cy2016-1/bipedal_wheeled_robot/模型/外固定2.stl

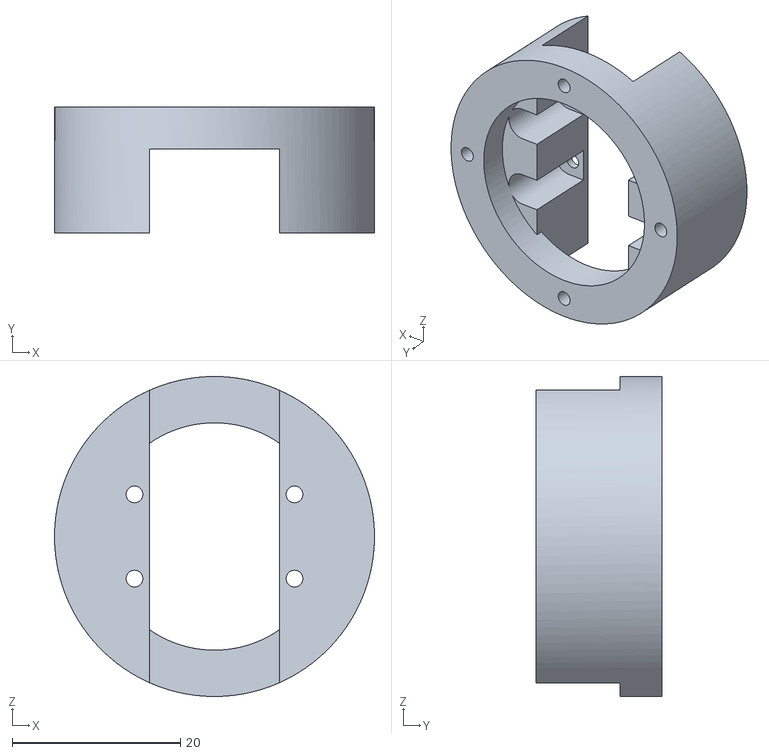
[picture p1: CAD file, 2024-07-26]
模型/外固定2.stl
38.0 x 15.0 x 38.0
