cy2016-1/bipedal_wheeled_robot/模型/舵机接口2.stl

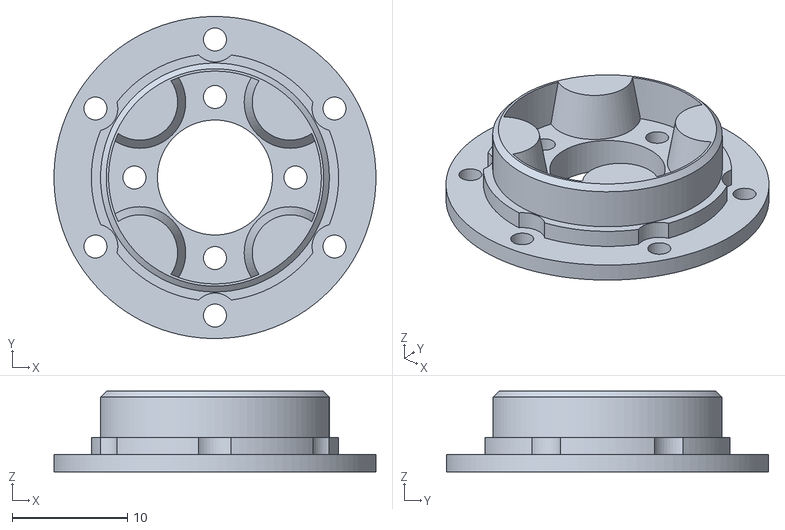
[picture p2: CAD file, 2024-07-26]
模型/舵机接口2.stl
28.0 x 28.0 x 7.00
