cy2016-1/bipedal_wheeled_robot/模型/盖板1.stl

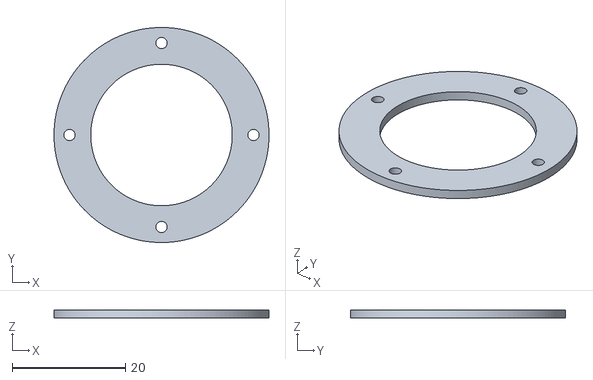
[picture p3: CAD file, 2024-07-26]
模型/盖板1.stl
38.0 x 38.0 x 1.50
