cy2016-1/bipedal_wheeled_robot/模型/上盖.stl

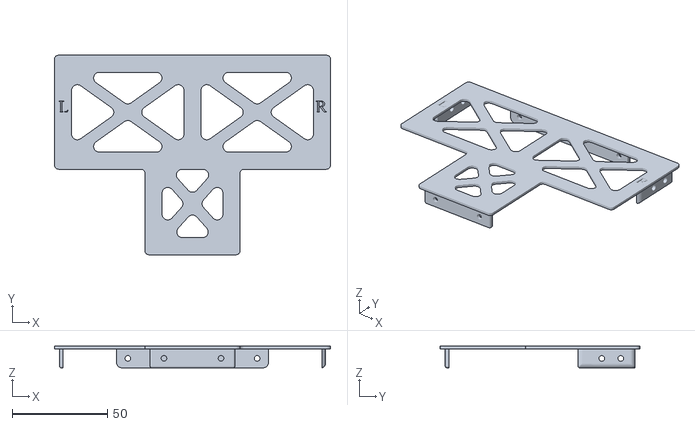
[picture p4: CAD file, 2024-06-26]
模型/上盖.stl
145.2 x 105.0 x 11.5
