cy2016-1/bipedal_wheeled_robot/模型/前小臂X1.stl

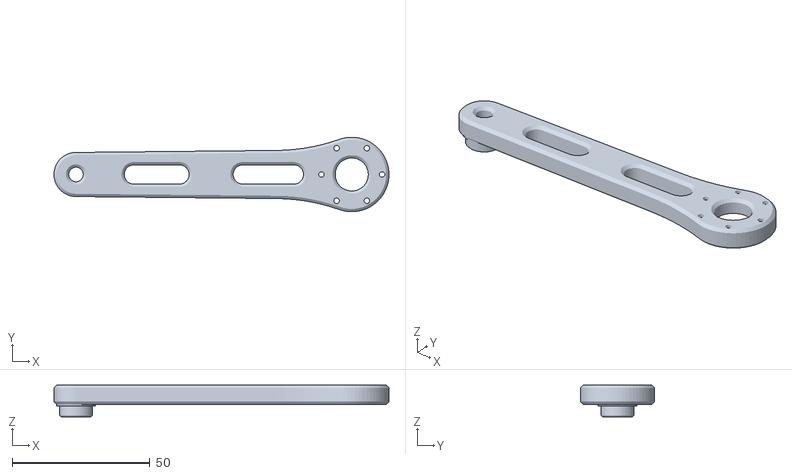
[picture p5: CAD file, 2024-06-26]
模型/前小臂X1.stl
121.5 x 27.0 x 11.5
