cy2016-1/bipedal_wheeled_robot/模型/轮固定X1.stl

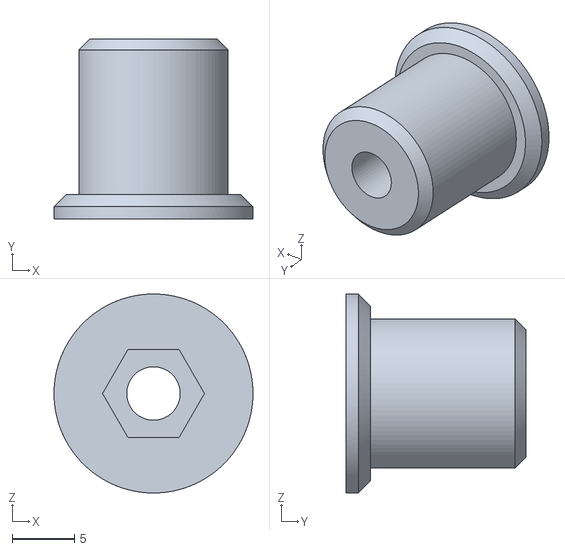
[picture p6: CAD file, 2024-06-26]
模型/轮固定X1.stl
16.0 x 14.5 x 16.0
