cy2016-1/bipedal_wheeled_robot/模型/轮毂X1.stl

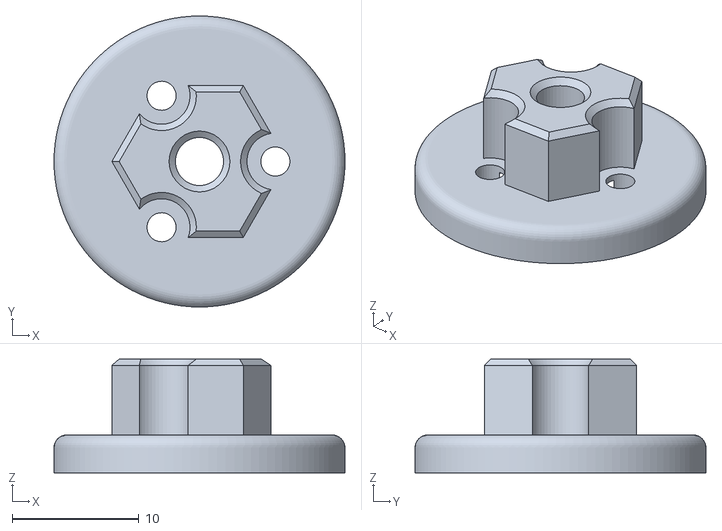
[picture p7: CAD file, 2024-06-26]
模型/轮毂X1.stl
23.0 x 23.0 x 9.00
