cy2016-1/bipedal_wheeled_robot/模型/框架.stl

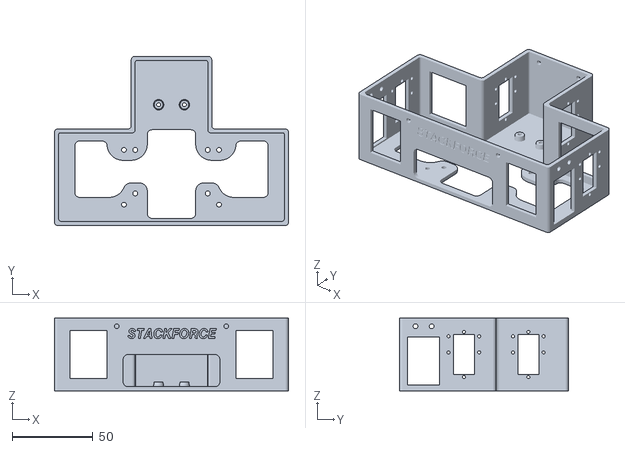
[picture p8: CAD file, 2024-06-26]
模型/框架.stl
145.2 x 105.0 x 45.0
