cy2016-1/bipedal_wheeled_robot/模型/后小臂X1.stl

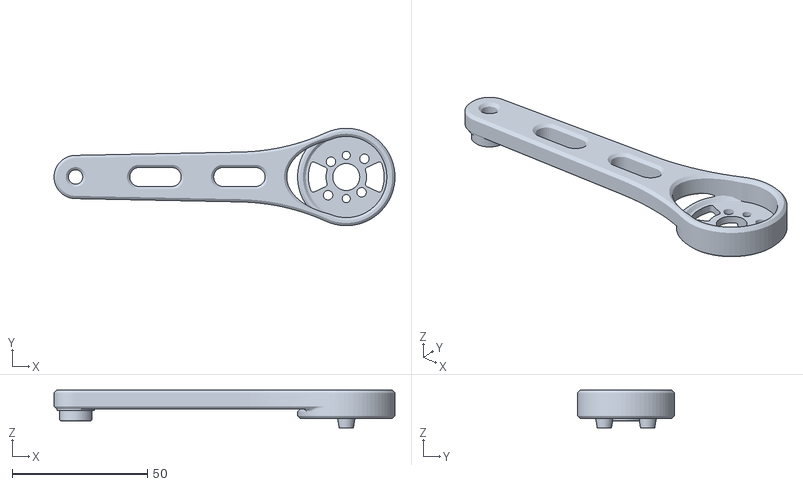
[picture p9: CAD file, 2024-06-26]
模型/后小臂X1.stl
126.0 x 36.0 x 14.0
