cy2016-1/bipedal_wheeled_robot/模型/大腿4.stl

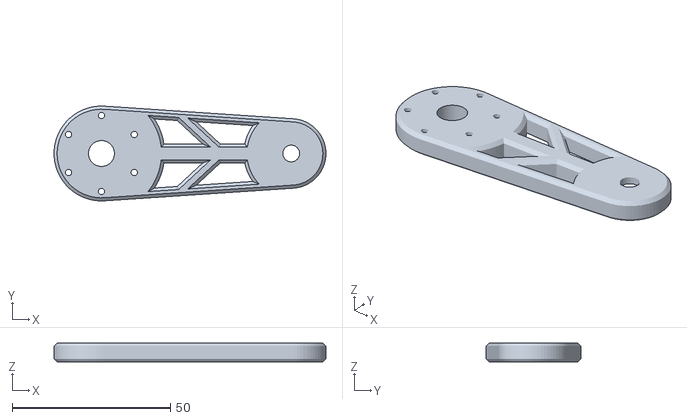
[picture p10: CAD file, 2024-06-26]
模型/大腿4.stl
86.0 x 30.0 x 6.00
