cy2016-1/bipedal_wheeled_robot/模型/电池架.stl

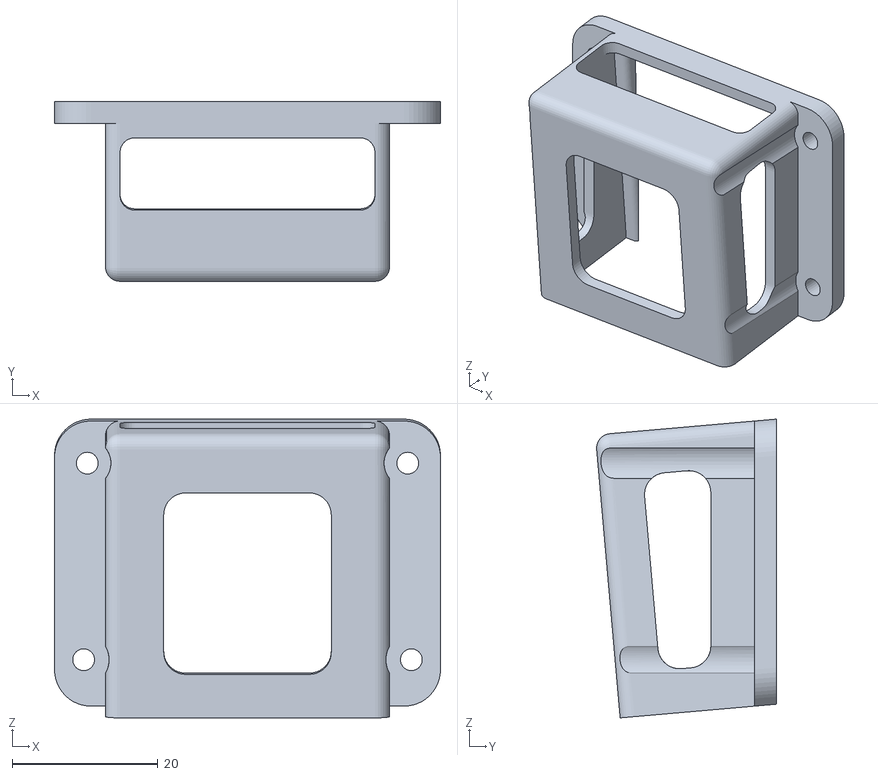
[picture p11: CAD file, 2024-06-26]
模型/电池架.stl
53.0 x 24.7 x 41.0
