cy2016-1/bipedal_wheeled_robot/模型/电机固定X1.stl

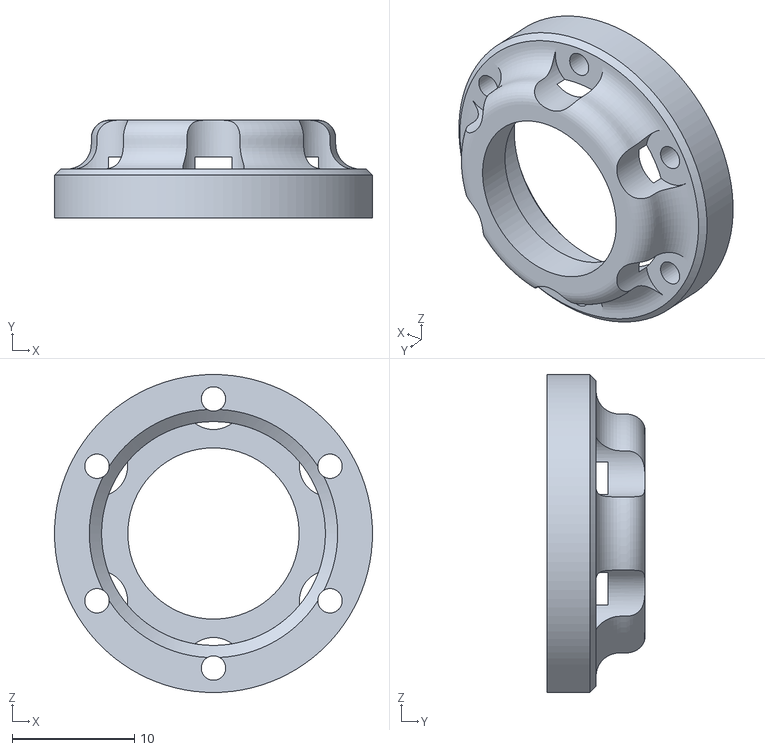
[picture p12: CAD file, 2024-06-26]
模型/电机固定X1.stl
26.0 x 8.00 x 26.0
