cy2016-1/bipedal_wheeled_robot/课程代码/第六课_运动学逆解/lesson6_HeightCtrl/src/main.cpp

#include <Arduino.h>
#include "SF_Servo.h"
#include "sbus.h"
#include "bipedal_data.h"

#define ROLL_OFFSET 0

SF_Servo servos = SF_Servo(Wire); //实例化舵机
bfs::SbusRx sbusRx(&Serial1);//实例化接收机

#define _constrain(amt, low, high) ((amt) < (low) ? (low) : ((amt) > (high) ? (high) : (amt))) // 限幅函数

void getRCValue();
void setServoAngle(uint16_t servoLeftFront, uint16_t servoLeftRear, uint16_t servoRightFront, uint16_t servoRightRear);
void inverseKinematics();

std::array<int16_t, bfs::SbusRx::NUM_CH()> sbusData;
IKparam IKParam;
float height;
uint8_t lowest = 70;
uint8_t highest = 130;
float X,Y;
float Y_demand;
float Kp_Y=0.1;

int16_t alphaLeftToAngle,betaLeftToAngle,alphaRightToAngle,betaRightToAngle;



void setup() {
  Serial.begin(921600);
  Wire.begin(1,2,400000UL);
  servos.init();
  servos.setAngleRange(0,300);
  servos.setPluseRange(500,2500);
  sbusRx.Begin(SBUSPIN,-1);
}

void loop() {
  getRCValue();
  Y_demand = ((int)map(RCValue[2], RCCHANNEL3_MIN, RCCHANNEL3_MAX, lowest, highest));

  X = 0;
  Y = Y + Kp_Y * (Y_demand - Y);

  IKParam.XLeft = X;
  IKParam.XRight = X;
  IKParam.YLeft = Y;
  IKParam.YRight = Y;
  // Serial.printf("%f,%f,%f\n",X,Y,Y_demand);

  inverseKinematics();
}

// 读取遥控器
void getRCValue(){
  if(sbusRx.Read()){
    sbusData = sbusRx.ch();
    RCValue[0] = sbusData[0];
    RCValue[1] = sbusData[1];
    RCValue[2] = sbusData[2];
    RCValue[3] = sbusData[3];
    RCValue[4] = sbusData[4];
    RCValue[5] = sbusData[5];

    RCValue[0] = _constrain(RCValue[0], RCCHANNEL_MIN, RCCHANNEL_MAX);
    RCValue[1] = _constrain(RCValue[1], RCCHANNEL_MIN, RCCHANNEL_MAX);
    RCValue[2] = _constrain(RCValue[2], RCCHANNEL3_MIN, RCCHANNEL3_MAX);
    RCValue[3] = _constrain(RCValue[3], RCCHANNEL_MIN, RCCHANNEL_MAX);
  }
}

void setServoAngle(uint16_t servoLeftFront, uint16_t servoLeftRear, uint16_t servoRightFront, uint16_t servoRightRear){
  // servos.setAngle(3, 90+servoLeftFront);//左前
  // servos.setAngle(4, 90+servoLeftRear);//左后
  // servos.setAngle(5, 270-servoRightFront);//右前
  // servos.setAngle(6, 270-servoRightRear);//右后
  servos.setAngle(3, servoLeftFront);//左前
  servos.setAngle(4, servoLeftRear);//左后
  servos.setAngle(5, servoRightFront);//右前
  servos.setAngle(6, servoRightRear);//右后
}



void inverseKinematics(){
  float alpha1,alpha2,beta1,beta2;
  uint16_t servoLeftFront,servoLeftRear,servoRightFront,servoRightRear;

  float aLeft = 2 * IKParam.XLeft * L1;
  float bLeft = 2 * IKParam.YLeft * L1;
  float cLeft = IKParam.XLeft * IKParam.XLeft + IKParam.YLeft * IKParam.YLeft + L1 * L1 - L2 * L2;
  float dLeft = 2 * L4 * (IKParam.XLeft - L5);
  float eLeft = 2 * L4 * IKParam.YLeft;
  float fLeft = ((IKParam.XLeft - L5) * (IKParam.XLeft - L5) + L4 * L4 + IKParam.YLeft * IKParam.YLeft - L3 * L3);

  alpha1 = 2 * atan((bLeft + sqrt((aLeft * aLeft) + (bLeft * bLeft) - (cLeft * cLeft))) / (aLeft + cLeft));
  alpha2 = 2 * atan((bLeft - sqrt((aLeft * aLeft) + (bLeft * bLeft) - (cLeft * cLeft))) / (aLeft + cLeft));
  beta1 = 2 * atan((eLeft + sqrt((dLeft * dLeft) + eLeft * eLeft - (fLeft * fLeft))) / (dLeft + fLeft));
  beta2 = 2 * atan((eLeft - sqrt((dLeft * dLeft) + eLeft * eLeft - (fLeft * fLeft))) / (dLeft + fLeft));

  alpha1 = (alpha1 >= 0)?alpha1:(alpha1 + 2 * PI);
  alpha2 = (alpha2 >= 0)?alpha2:(alpha2 + 2 * PI);

  if(alpha1 >= PI/4) IKParam.alphaLeft = alpha1;
  else IKParam.alphaLeft = alpha2;
  if(beta1 >= 0 && beta1 <= PI/4) IKParam.betaLeft = beta1;
  else IKParam.betaLeft = beta2;
  
  float aRight = 2 * IKParam.XRight * L1;
  float bRight = 2 * IKParam.YRight * L1;
  float cRight = IKParam.XRight * IKParam.XRight + IKParam.YRight * IKParam.YRight + L1 * L1 - L2 * L2;
  float dRight = 2 * L4 * (IKParam.XRight - L5);
  float eRight = 2 * L4 * IKParam.YRight;
  float fRight = ((IKParam.XRight - L5) * (IKParam.XRight - L5) + L4 * L4 + IKParam.YRight * IKParam.YRight - L3 * L3);

  IKParam.alphaRight = 2 * atan((bRight + sqrt((aRight * aRight) + (bRight * bRight) - (cRight * cRight))) / (aRight + cRight));
  IKParam.betaRight = 2 * atan((eRight - sqrt((dRight * dRight) + eRight * eRight - (fRight * fRight))) / (dRight + fRight));

  alpha1 = 2 * atan((bRight + sqrt((aRight * aRight) + (bRight * bRight) - (cRight * cRight))) / (aRight + cRight));
  alpha2 = 2 * atan((bRight - sqrt((aRight * aRight) + (bRight * bRight) - (cRight * cRight))) / (aRight + cRight));
  beta1 = 2 * atan((eRight + sqrt((dRight * dRight) + eRight * eRight - (fRight * fRight))) / (dRight + fRight));
  beta2 = 2 * atan((eRight - sqrt((dRight * dRight) + eRight * eRight - (fRight * fRight))) / (dRight + fRight));

  alpha1 = (alpha1 >= 0)?alpha1:(alpha1 + 2 * PI);
  alpha2 = (alpha2 >= 0)?alpha2:(alpha2 + 2 * PI);

  if(alpha1 >= PI/4) IKParam.alphaRight = alpha1;
  else IKParam.alphaRight = alpha2;
  if(beta1 >= 0 && beta1 <= PI/4) IKParam.betaRight = beta1;
  else IKParam.betaRight = beta2;

  alphaLeftToAngle = (int)((IKParam.alphaLeft / 6.28) * 360);//弧度转角度
  betaLeftToAngle = (int)((IKParam.betaLeft / 6.28) * 360);

  alphaRightToAngle = (int)((IKParam.alphaRight / 6.28) * 360);
  betaRightToAngle = (int)((IKParam.betaRight / 6.28) * 360);

  servoLeftFront = 90 + betaLeftToAngle;
  servoLeftRear = 90 + alphaLeftToAngle;
  servoRightFront = 270 - betaRightToAngle;
  servoRightRear = 270 - alphaRightToAngle;

  setServoAngle(servoLeftFront,servoLeftRear,servoRightFront,servoRightRear);
}
