cy2016-1/bipedal_wheeled_robot/(commit log)

2024-06-26 新建 模型
2024-07-01 新建 BOM
2024-07-01 上传BOM
    [StackForce双足轮BOM.xlsx]
2024-07-05 删除文件 BOM/StackForce双足轮BOM.xlsx
    [StackForce双足轮BOM.xlsx]
2024-07-05 更新BOM
    [StackForce双足轮BOM.xlsx]
2024-07-26 删除文件 模型
    [上盖.stl, 前大臂x1.stl, 前大臂x2.stl, 前小臂X1.stl, 前小臂X2.stl, 后大臂X1.stl, 后大臂X2.stl, 后小臂X1.stl]
2024-07-26 删除文件 BOM
    [StackForce双足轮BOM.xlsx]
2024-07-26 add 模型.
2024-07-26 上传模型
    [后小臂X1.stl, 后小臂X2.stl, 大腿1.stl, 大腿2.stl, 大腿3.stl, 大腿4.stl, 框架.stl, 电机固定X1.stl]
2024-08-30 新建 课程代码
